Strat00s/PA176-Pi_PoE_HAT/vault/PD.md

# Required components
2 bridge rectifiers
PD IC with DCDC controller
OR
PD IC and seperate DCDC controller
Pasive components for DCDC fly-buck converter

### Possible PDs
| Name | Type | Price |
| --- | --- | --- |
| PD70100 | PD | 36,00,-  |
| PD70200 | PD | 42,24,-  |
| PD70101 | PD, DRV | 59,76,-  |
| PD70201 | PD, DRV | 65,36,-  |
| TPS2378 | PD | 54,48,-  |
| MP8001 | PD | 48,48,-  |
| NCP1090DG | PD | 40,975,- |
| MP8003A | PD | 54,146,- |
| MP8009GV | PD, DRV | 64,39,-  |
| MP8007GV | PD, FET | 54,24,-  |
| KTA1136EUAE | PD, FET | 54,72,-  |

PD70101 or PD70201 look the best (builtin controller)
or PD70100 with some very cheap controller

https://cz.farnell.com/monolithic-power-systems-mps/mp8007gv-p/poe-controller-40-to-125deg-c/dp/3358217RL
https://cz.farnell.com/monolithic-power-systems-mps/mp8009gv-p/power-over-ethernet-250khz-125deg/dp/3810345RL

MP8009GV - available, PD and PWM, PoE+
MP8007GV - available, PD and FET, PoE

https://cz.mouser.com/ProductDetail/Kinetic-Technologies/KTA1136EUAE-TR?qs=eP2BKZSCXI6TyUWlHyOIJw%3D%3D
KTA1136EUAE-TR - available, PD and FET, PoE

https://cz.mouser.com/ProductDetail/Kinetic-Technologies/KTA1137AEUAB-TR?qs=B6kkDfuK7%2FC2ceb5uybLMQ%3D%3D
KTA1137AEUAB-TR - PD and PWM, PoE+	

https://cz.mouser.com/ProductDetail/Kinetic-Technologies/KTA1136EUAE-TR?qs=eP2BKZSCXI6TyUWlHyOIJw%3D%3D

https://cz.mouser.com/ProductDetail/STMicroelectronics/PM8804TR?qs=MLItCLRbWswribPKt%252BQVPQ%3D%3D
cheapest PD with PWM

https://cz.mouser.com/c/semiconductors/power-management-ics/power-switch-ics-poe-lan/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
