Strat00s/PA176-Pi_PoE_HAT/vault/Magnetics.md

#Required components
2x bridge rectifiers and magnetics

[PT61020EL Bourns | Mouser Europe](https://eu.mouser.com/ProductDetail/Bourns/PT61020EL?qs=sohxTYoD%252Bqttdr7IVMiKKg%3D%3D)
[H6062NL Pulse Electronics | Mouser Czech Republic](https://cz.mouser.com/ProductDetail/Pulse-Electronics/H6062NL?qs=hlTQ6wBu%252Bnnq8WII%2F92SGQ%3D%3D)
PoE++, 2.91e
[SM51625EL Bourns | Mouser Czech Republic](https://uk.farnell.com/bourns/sm51625el/xfmr-10-100-1000-base-t-poe-1p/dp/3373359RL)
PoE+, 2.84e
[SM51589PEL Bourns | Mouser Czech Republic](https://eu.mouser.com/datasheet/2/54/sm51589pel-778121.pdf)

### Possible mags
| Name | Type | Price |
| --- | --- | --- |
| PT61020EL  | PoE | 61,68,-  |
| SM51625EL  | PoE++ | 69,84,-  |
| SM51589PEL | PoE+ | 68,16,-  |
