Strat00s/PA176-Pi_PoE_HAT/2018041917483119.png

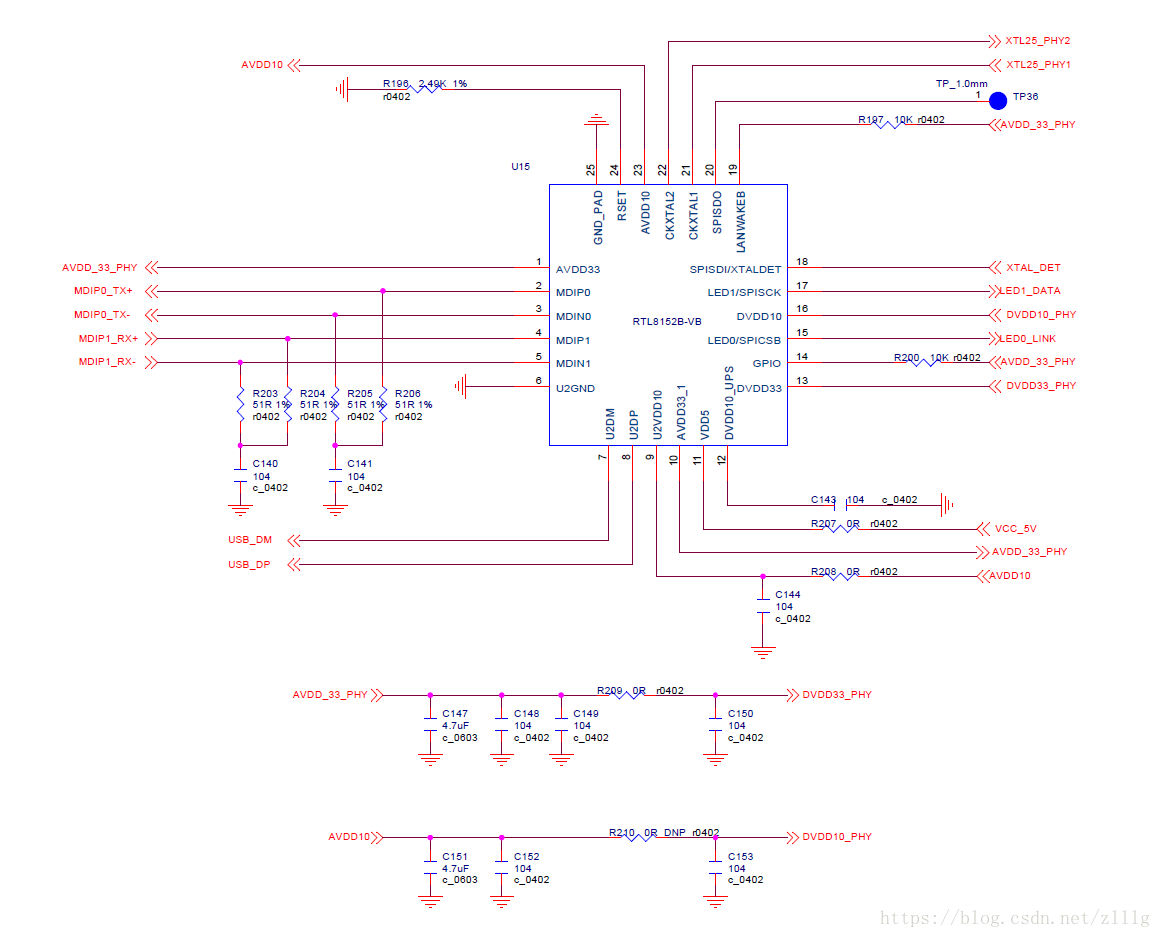
2018041917483119.png
