Strat00s/PA176-Pi_PoE_HAT/vault/Pasted image 20230218222756.png

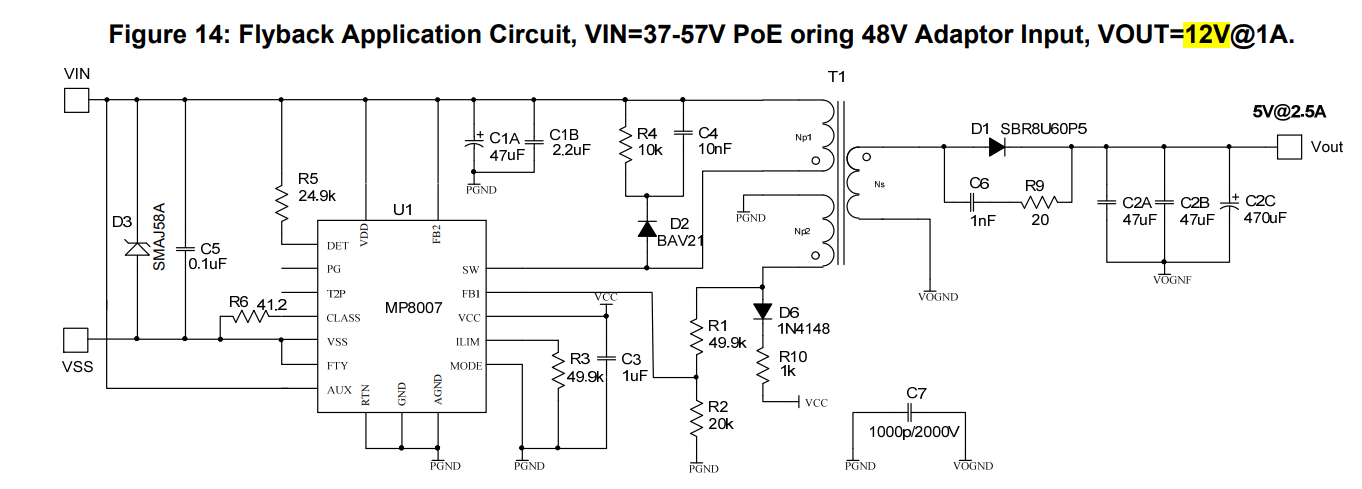
vault/Pasted image 20230218222756.png
