Strat00s/PA176-Pi_PoE_HAT/vault/Pasted image 20230218222824.png

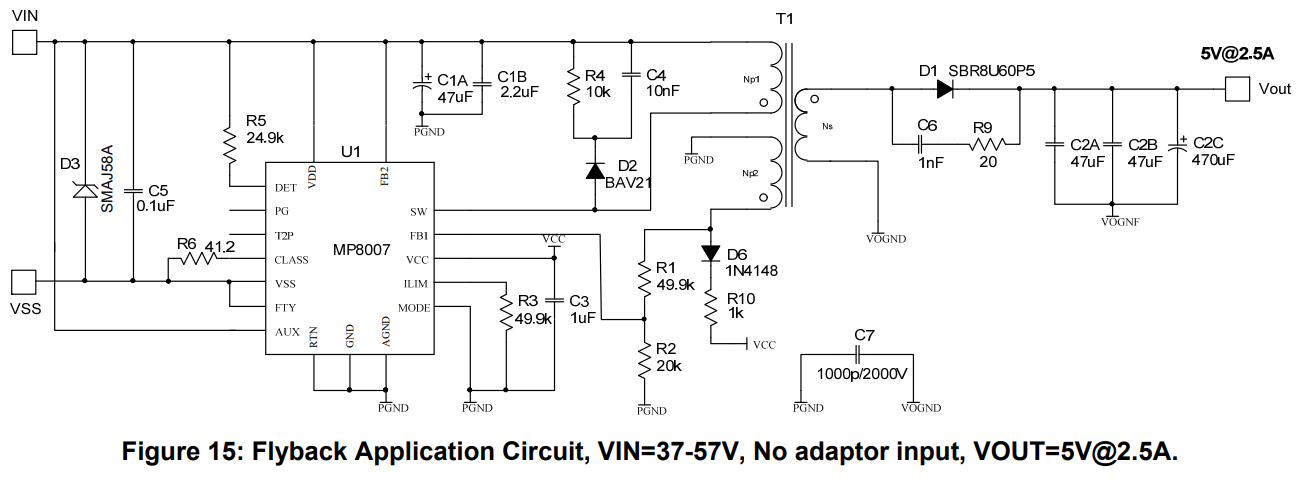
vault/Pasted image 20230218222824.png
