Strat00s/PA176-Pi_PoE_HAT/vault/Components.md

# 1. RJ45 port
Least of my problems right now.
Just get one without integrated magnetics

# 2. Magnetics
Have to be gigabit PoE capable. 

PoE, 2.57e
[PT61020EL Bourns | Mouser Europe](https://eu.mouser.com/ProductDetail/Bourns/PT61020EL?qs=sohxTYoD%252Bqttdr7IVMiKKg%3D%3D)
[H6062NL Pulse Electronics | Mouser Czech Republic](https://cz.mouser.com/ProductDetail/Pulse-Electronics/H6062NL?qs=hlTQ6wBu%252Bnnq8WII%2F92SGQ%3D%3D)
PoE++, 2.91e
[SM51625EL Bourns | Mouser Czech Republic](https://uk.farnell.com/bourns/sm51625el/xfmr-10-100-1000-base-t-poe-1p/dp/3373359RL)
### PoE+, 2.84e
[SM51589PEL Bourns | Mouser Czech Republic](https://eu.mouser.com/datasheet/2/54/sm51589pel-778121.pdf)
Diodes requiret for rectification

# 3. PD IC (optional)
If going active PD is required for handshake

[Power Switch ICs - POE/LAN – Mouser Czech Republic](https://cz.mouser.com/c/semiconductors/power-management-ics/power-switch-ics-poe-lan/)

MP6007
![[Pasted image 20230218222824.png]]

### PD70100/PD70200
[PD70100/PD70200 Datasheet (mouser.com)](https://cz.mouser.com/datasheet/2/268/PD70100_PD70200_IEEE_802_3afat_Front_End_IC_Datash-2578760.pdf)
- Cheapest for 1 piece
![[Pasted image 20230219100333.png]]

# 4. Step down convertor
Fully DIY or prebuilt
# 5. USB to ETH bridge
gigabit capable
# 6. USB HUB (optional)
