Strat00s/PA176-Pi_PoE_HAT/vault/parts.md

Magnetics:
Bourns PT61020xx: https://uk.farnell.com/bourns/pt61020el/transformer-base-t-350uh/dp/2313530RL?st=pt61020#anchorTechnicalDOCS
Bourns SM51625xx: https://uk.farnell.com/bourns/sm51625el/xfmr-10-100-1000-base-t-poe-1p/dp/3373359RL
