Strat00s/PA176-Pi_PoE_HAT/(list of files, cad)

Other CAD files:
pi_poe_hat/POE70P-50LD/Allegro/poe70p50ld.psm
pi_poe_hat/POE70P-50LD/DEHDL/poe70p_50ld/chips/chips.prt
