Strat00s/PA176-Pi_PoE_HAT/USB_HUB_Board_SchDoc.pdf

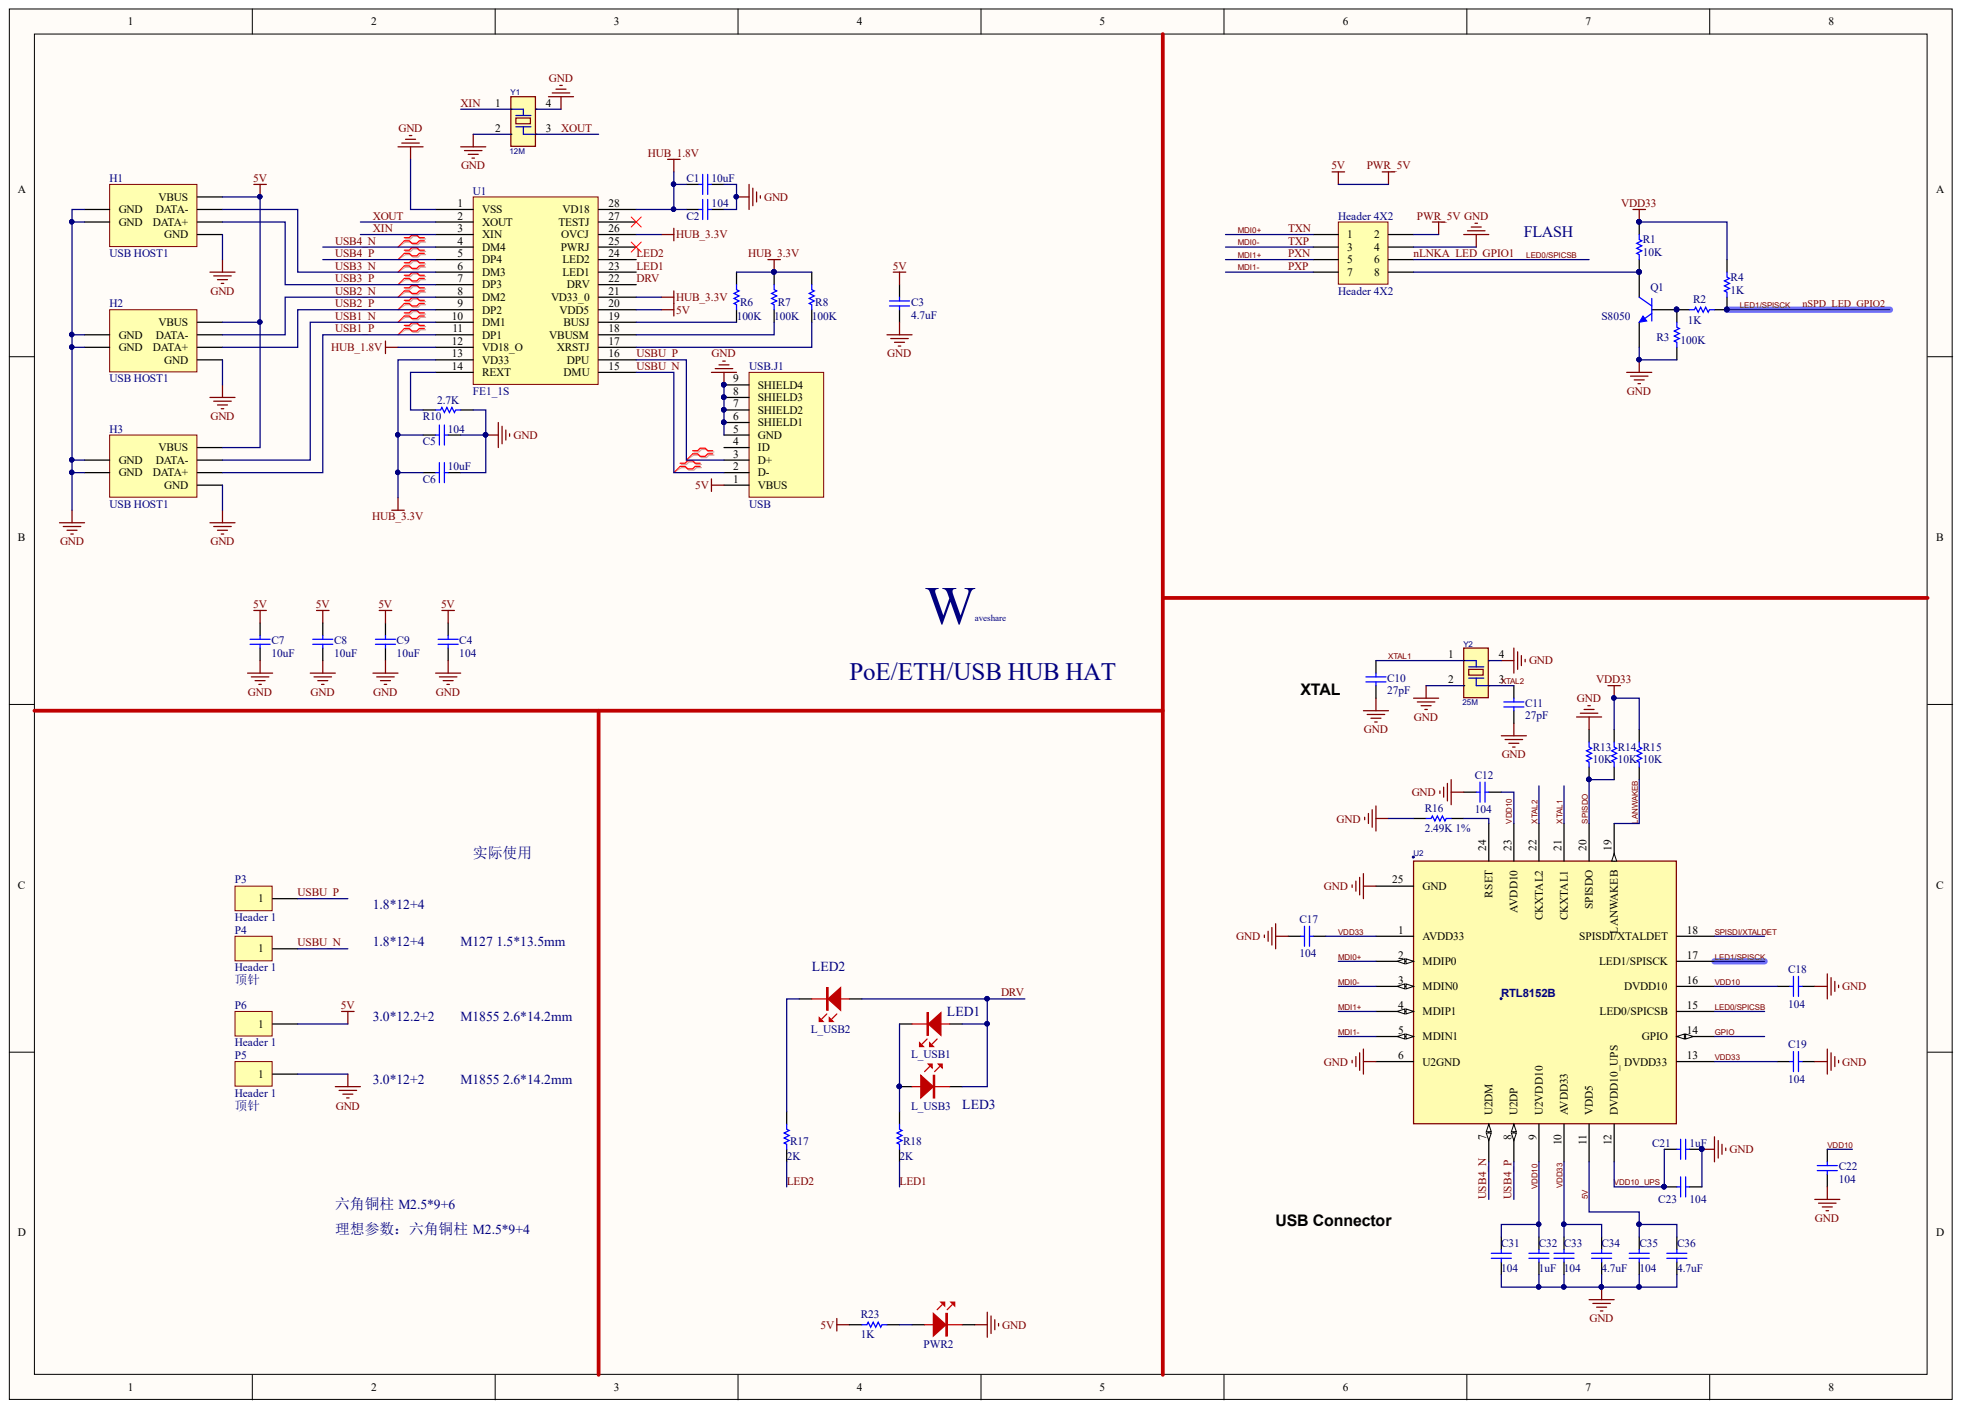
[picture p5: page 1]

USB1_P | DP1 11

VD18_O 12
VD33 13 | USBU_P GND

USBU_N

PoE/ETH/USB HUB HAT
