Strat00s/PA176-Pi_PoE_HAT/(list of files, drawings)

Other design files:
pi_poe_hat/POE70P-50LD/Altium/POE70P50LD.PcbLib
pi_poe_hat/POE70P-50LD/Altium/POE70P-50LD.SchLib
