Strat00s/PA176-Pi_PoE_HAT/pi_poe_hat/pi_poe_hat.kicad_pcb

## KiCad design pi_poe_hat/pi_poe_hat.kicad_pcb (2023-05-16)

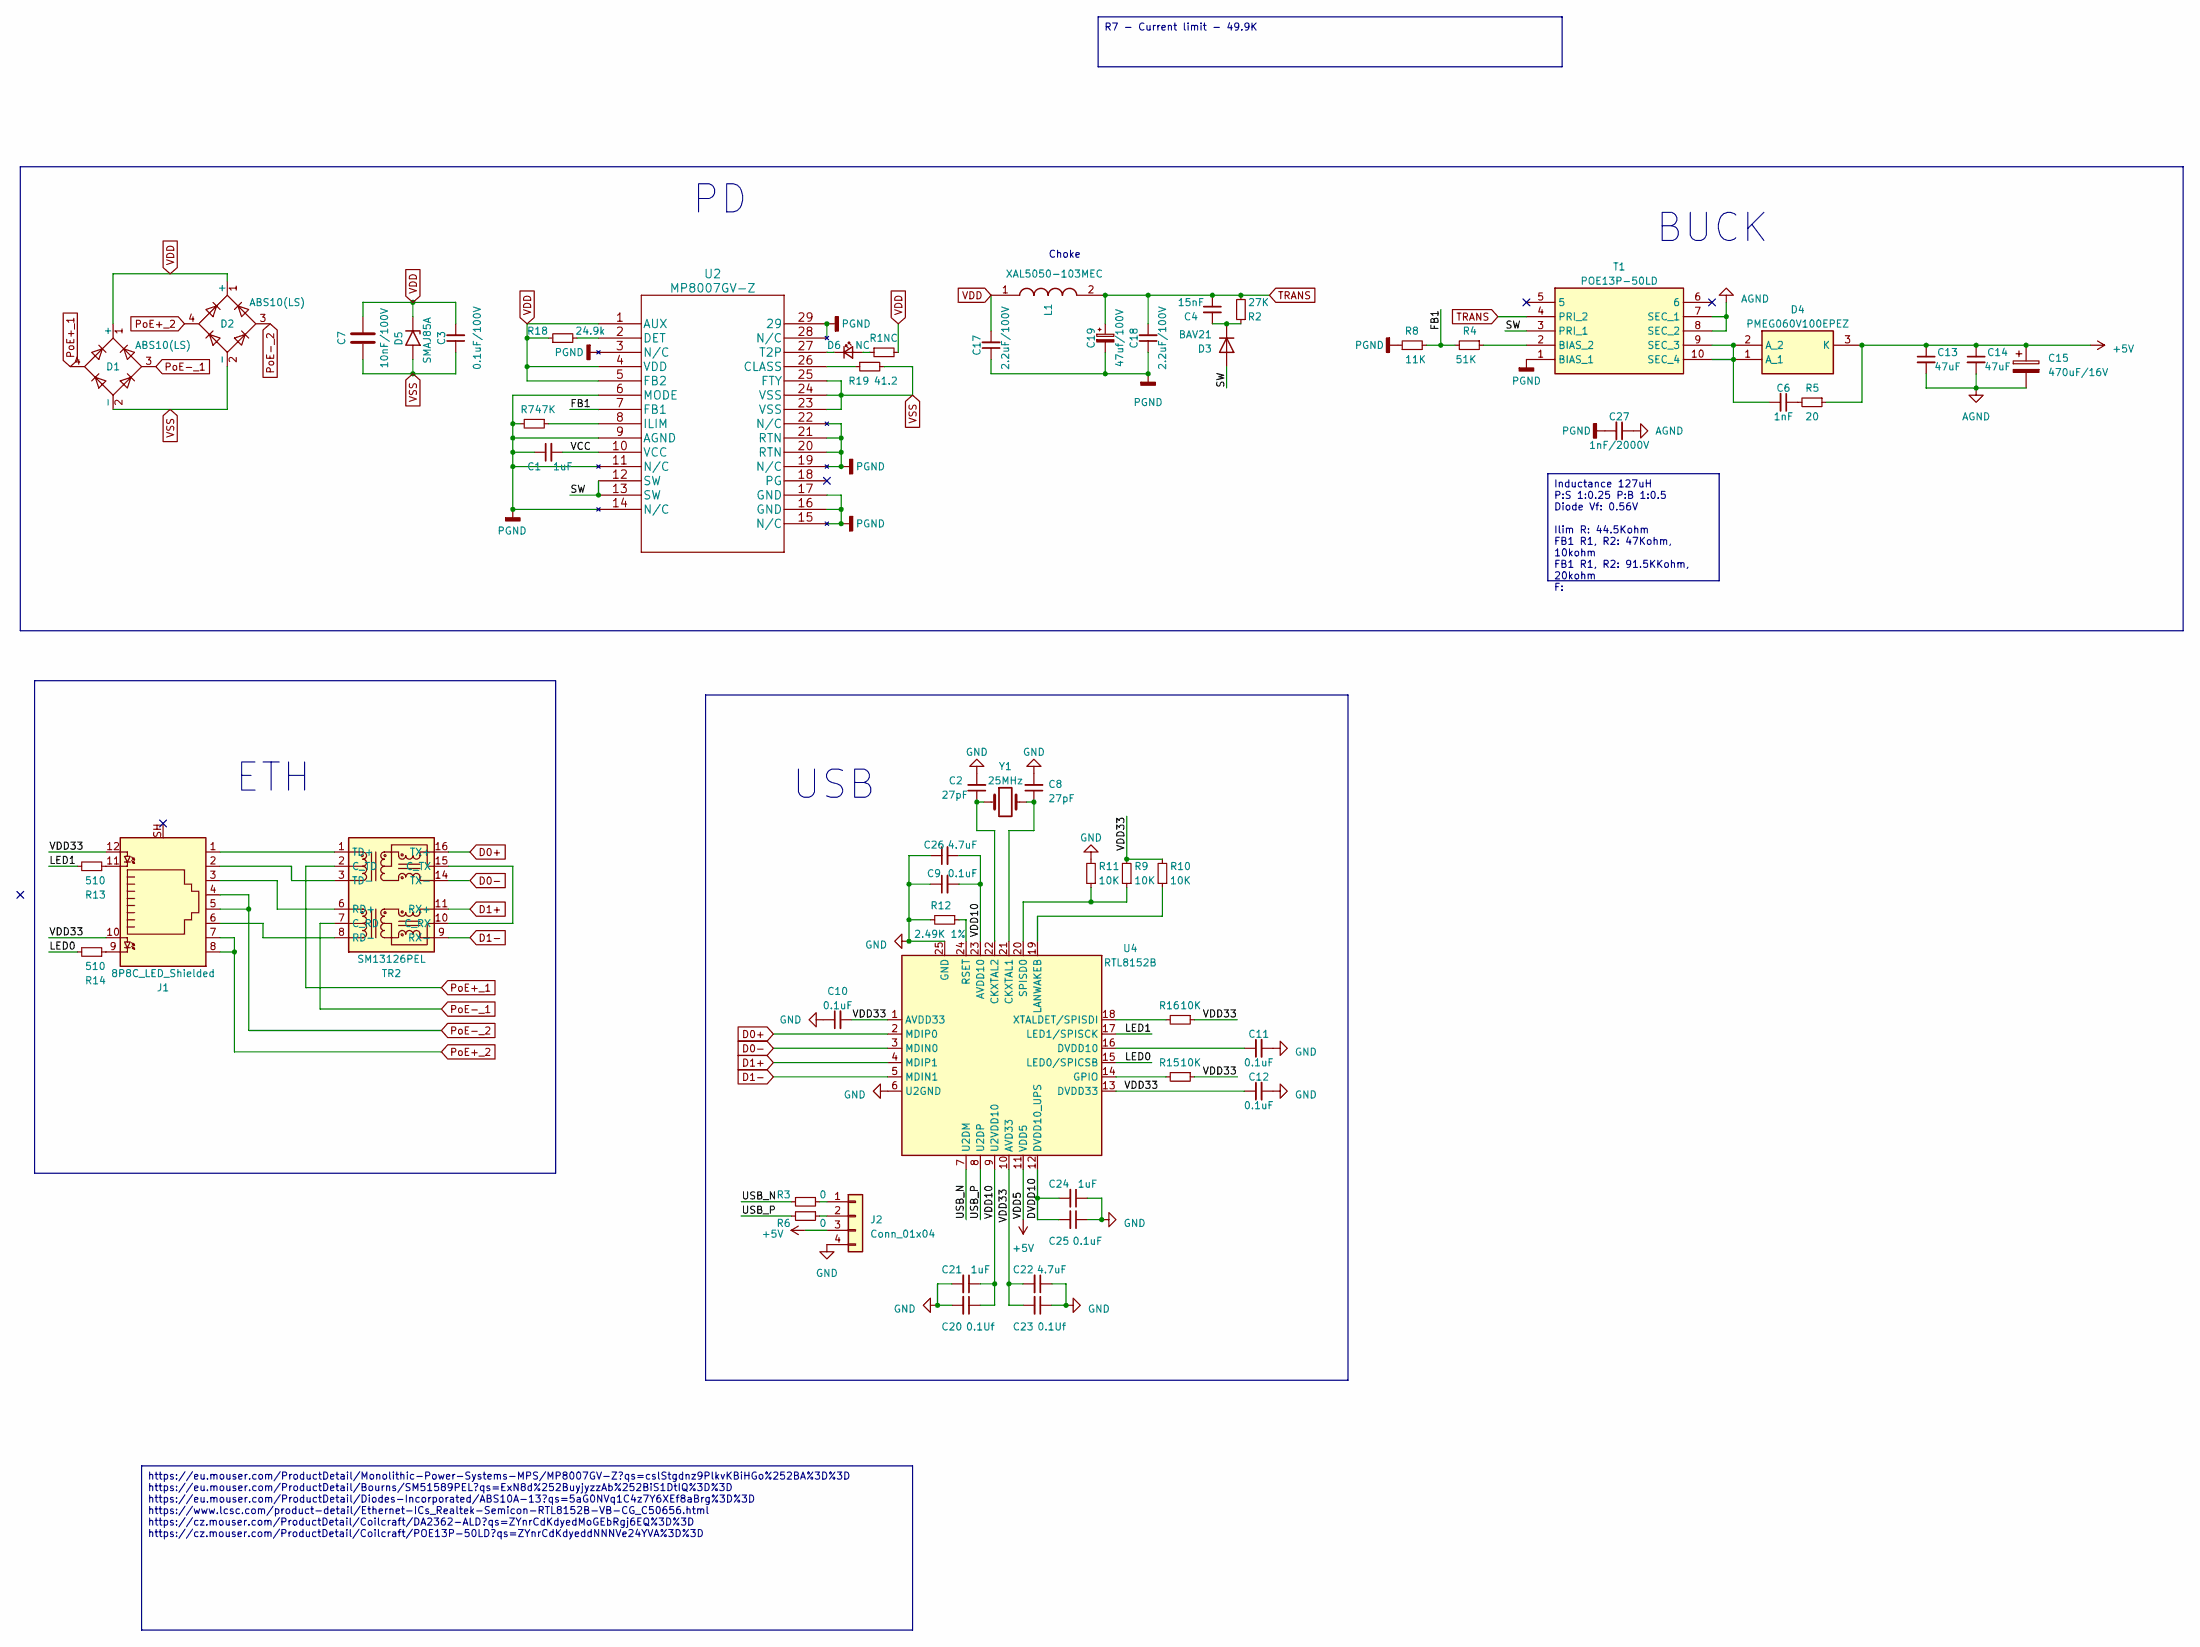
[picture p6: schematic pi_poe_hat.kicad_sch]

Parts:
C1, C21, C24: 1uF; C_0603_1608Metric_Pad1.08x0.95mm_HandSolder
C2, C8: 27pF; C_0603_1608Metric_Pad1.08x0.95mm_HandSolder
C3: 0.1uF/100V; C_1206_3216Metric_Pad1.33x1.80mm_HandSolder
C4: 15nF; C_0805_2012Metric_Pad1.18x1.45mm_HandSolder
C6: 1nF; C_0603_1608Metric_Pad1.08x0.95mm_HandSolder
C7: 10nF/100V; C_0805_2012Metric_Pad1.18x1.45mm_HandSolder
C9, C10, C11, C12, C25: 0.1uF; C_0603_1608Metric_Pad1.08x0.95mm_HandSolder
C13, C14: 47uF; C_1210_3225Metric_Pad1.33x2.70mm_HandSolder
C15: 470uF/16V; CP_Radial_D10.0mm_P5.00mm
C17, C18: 2.2uF/100V; C_1210_3225Metric_Pad1.33x2.70mm_HandSolder
C19: 47uf/100V; CP_Radial_D8.0mm_P3.50mm
C20, C23: 0.1Uf; C_0603_1608Metric_Pad1.08x0.95mm_HandSolder
C22, C26: 4.7uF; C_0805_2012Metric_Pad1.18x1.45mm_HandSolder
C27: 1nF/2000V; C_1812_4532Metric_Pad1.57x3.40mm_HandSolder
D1, D2: ABS10(LS); Diode_Bridge_Diotec_ABS
D3: BAV21; D_SOD-123
D4: PMEG060V100EPEZ; Manufacturer_Part_Number PMEG060V100EPEZ
D5: SMAJ85A; D_SMA
D6: NC; LED_0603_1608Metric_Pad1.05x0.95mm_HandSolder
J1: 8P8C_LED_Shielded; RJ45_Amphenol_RJHSE538X
J2: Conn_01x04; PinHeader_1x04_P2.54mm_Vertical
L1: XAL5050-103MEC; L_Coilcraft_XAL5050-XXX; Manufacturer_Part_Number XAL5050-103MEC; Mouser Part Number 994-XAL5050-103MEC
R1: NC; R_0603_1608Metric_Pad0.98x0.95mm_HandSolder
R2: 27K; R_1206_3216Metric_Pad1.30x1.75mm_HandSolder
R3, R6: 0; R_0603_1608Metric_Pad0.98x0.95mm_HandSolder
R4: 51K; R_0603_1608Metric_Pad0.98x0.95mm_HandSolder
R5: 20; R_0805_2012Metric_Pad1.20x1.40mm_HandSolder
R7: 47K; R_0603_1608Metric_Pad0.98x0.95mm_HandSolder
R8: 11K; R_0603_1608Metric_Pad0.98x0.95mm_HandSolder
R9, R10, R11, R15, R16: 10K; R_0603_1608Metric_Pad0.98x0.95mm_HandSolder
R12: 2.49K 1%; R_0603_1608Metric_Pad0.98x0.95mm_HandSolder
R13, R14: 510; R_0603_1608Metric_Pad0.98x0.95mm_HandSolder
R18: 24.9k; R_0603_1608Metric_Pad0.98x0.95mm_HandSolder
R19: 41.2; R_0603_1608Metric_Pad0.98x0.95mm_HandSolder
T1: POE13P-50LD; POE13P50LD; Mouser Part Number 994-POE13P-50LD
TR2: SM13126PEL; Transformer_Ethernet_Bourns_PT61017PEL
U2: MP8007GV-Z
U4: RTL8152B; QFN-24-1EP_4x4mm_P0.5mm_EP2.6x2.6mm
Y1: 25MHz; ABLS

Connections:
+5V: C13.1, C14.1, C15.1, D4.3 (K), J2.3, R5.1, U4.11 (VDD5)
/DVDD10: C24.2, C25.2, U4.12 (DVDD10_UPS)
/FB1: R4.2, R8.2, U2.7 (FB1)
/LED0: R14.2, U4.15 (LED0/SPICSB)
/LED1: R13.2, U4.17 (LED1/SPISCK)
/SW: D3.2 (A), T1.3 (PRI_1), U2.12 (SW), U2.13 (SW)
/USB_N: R3.2, U4.7 (U2DM)
/USB_P: R6.2, U4.8 (U2DP)
/VCC: C1.2, U2.10 (VCC)
/VDD10: C9.2, C20.1, C21.1, C26.2, U4.9 (U2VDD10), U4.23 (AVDD10)
/VDD33: C10.2, C12.1, C22.2, C23.2, J1.10, J1.12, R9.2, R10.2, R15.1, R16.1, U4.1 (AVDD33), U4.10 (AVD33), U4.13 (DVDD33)
D0+: TR2.16 (TX+), U4.2 (MDIP0)
D0-: TR2.14 (TX-), U4.3 (MDIN0)
D1+: TR2.11 (RX+), U4.4 (MDIP1)
D1-: TR2.9 (RX-), U4.5 (MDIN1)
GNDD: C1.1, C17.1, C18.1, C19.2, C27.2, R7.2, R8.1, T1.1 (BIAS_1), U2.3 (N/C), U2.6 (MODE), U2.9 (AGND), U2.11 (N/C), U2.14 (N/C), U2.15 (N/C), U2.16 (GND), U2.17 (GND), U2.19 (N/C), U2.20 (RTN), U2.21 (RTN), U2.22 (N/C), U2.28 (N/C), U2.29
unnamed: C6.1, R5.2
unnamed: C4.2, D3.1 (K), R2.1
unnamed: C6.2, D4.1 (A_1), D4.2 (A_2), T1.9 (SEC_3), T1.10 (SEC_4)
unnamed: D6.2 (A), R1.1
unnamed: D6.1 (K), U2.27 (T2P)
unnamed: J1.9, R14.1
unnamed: J1.11, R13.1
unnamed: J2.1, R3.1
unnamed: J2.2, R6.1
unnamed: R4.1, T1.2 (BIAS_2)
unnamed: TR2.10 (C_RX), TR2.15 (C_TX)
unnamed: J1.3, TR2.6 (RD+)
unnamed: J1.6, TR2.8 (RD-)
unnamed: J1.1, TR2.1 (TD+)
unnamed: J1.2, TR2.3 (TD-)
unnamed: R19.1, U2.26 (CLASS)
unnamed: R18.2, U2.2 (DET)
unnamed: R7.1, U2.8 (ILIM)
unnamed: C8.1, U4.21 (CKXTAL1), Y1.2
unnamed: C2.1, U4.22 (CKXTAL2), Y1.1
unnamed: C11.1, U4.16 (DVDD10)
unnamed: R15.2, U4.14 (GPIO)
unnamed: R10.1, U4.19 (LANWAKEB)
unnamed: R12.1, U4.24 (RSET)
unnamed: R9.1, R11.1, U4.20 (SPISD0)
unnamed: R16.2, U4.18 (XTALDET/SPISDI)
PoE+_1: D1.4, TR2.2 (C_TD)
PoE+_2: D2.4, J1.7, J1.8
PoE-_1: D1.3, TR2.7 (C_RD)
PoE-_2: D2.3, J1.4, J1.5
TRANS: C4.1, C18.2, C19.1, L1.2, R2.2, T1.4 (PRI_2), T1.5
VDD: C3.2, C7.2, C17.2, D1.1 (+), D2.1 (+), D5.1 (A1), L1.1, R1.2, R18.1, U2.1 (AUX), U2.4 (VDD), U2.5 (FB2)
VSS: C3.1, C7.1, D1.2 (-), D2.2 (-), D5.2 (A2), R19.2, U2.23 (VSS), U2.24 (VSS), U2.25 (FTY)

Notes on the sheet:
R7 - Current limit - 49.9K
Inductance 127uH P:S 1:0.25 P:B 1:0.5 Diode Vf: 0.56V Ilim R: 44.5Kohm FB1 R1, R2: 47Kohm, 10kohm FB1 R1, R2: 91.5KKohm, 20kohm F:
https://eu.mouser.com/ProductDetail/Monolithic-Power-Systems-MPS/MP8007GV-Z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 https://eu.mouser.com/ProductDetail/Bourns/SM51589PEL?qs=ExN8d%252BuyjyzzAb%252BiS1DtIQ%3D%3D https://eu.mouser.com/ProductDetail/Diodes-Incorporated/ABS10A-13?qs=5aG0NVq1C4z7Y6XEf8aBrg%3…
Choke
BUCK
USB
ETH

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
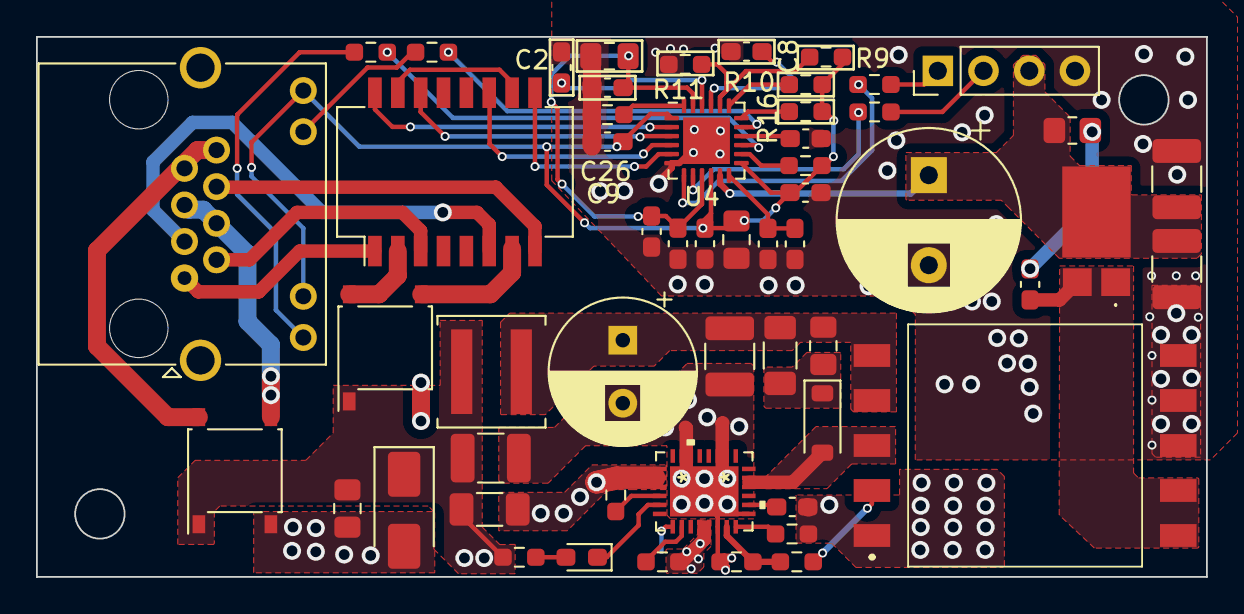
[picture p7: board pi_poe_hat.kicad_pcb from above]

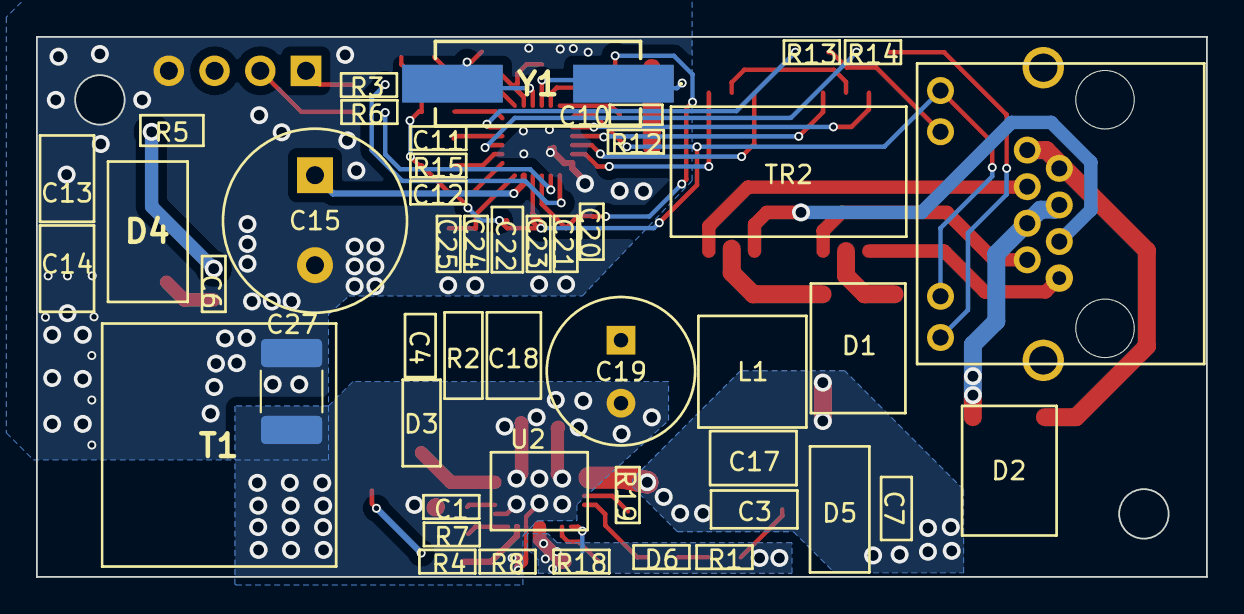
[picture p8: board pi_poe_hat.kicad_pcb from below]

Board: 2 copper layers, 65.0 x 30.0 mm, 57 parts (2 on the bottom side), 50 nets.
