Strat00s/PA176-Pi_PoE_HAT/(commit log)

2023-03-07 pcb start
    [pi_poe_hat.kicad_pcb, pi_poe_hat.kicad_sch]
2023-03-09 PD done???
    [pi_poe_hat.kicad_pcb, pi_poe_hat.kicad_sch]
2023-03-14 almost done
    [EDI2CAP.CFG, POE70P-50LD.SchLib, POE70P50LD.PcbLib, chips.prt, pi_poe_hat.csv, pi_poe_hat.kicad_sch, poe70p50ld.psm]
2023-03-23 pcb continue
    [pi_poe_hat.kicad_pcb]
2023-04-04 pcb footprint done
    [pi_poe_hat.kicad_pcb, pi_poe_hat.kicad_sch]
2023-04-04 v 1.0 of pcb almost done
    [pi_poe_hat.kicad_pcb, pi_poe_hat.kicad_sch]
2023-04-06 second pcb almost done
    [pi_poe_hat.kicad_sch, pi_poe_hat_backup.kicad_pcb]
2023-04-06 pcb almost done
    [pi_poe_hat.kicad_pcb]
2023-04-06 second pcb done
    [pi_poe_hat.kicad_pcb]
2023-04-07 pcb done
    [pi_poe_hat.kicad_pcb]
2023-05-16 new possible fix img
    [pi_poe_hat.kicad_pcb]
