Strat00s/PA176-Pi_PoE_HAT/(notices)

Notices in the files:
parts and their libraries:
Copyright 2021 Accelerated Designs. All rights reserved.
